nashriveraramirez0520-art/Duet-MIDI/docs/images/README.md

# Design screenshots

- `schematic.png`: schematic screenshot supplied with the project.
- `pcb-layout.png`: routed layout with final control labels.
- `pcb-front-3d.png` and `pcb-back-3d.png`: KiCad 3D views; some component models are missing.
- `routing-drc.png`: zero-violation, zero-unconnected routing check, before final reference-text cleanup; schematic parity was disabled and five checks ignored.

These are design screenshots, not photographs of assembled hardware.
