nashriveraramirez0520-art/Duet-MIDI/docs/images/pcb-back-3d.png

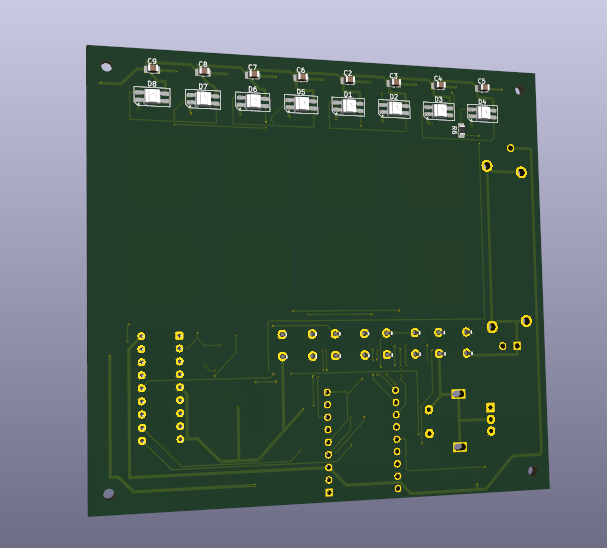
docs/images/pcb-back-3d.png
