nashriveraramirez0520-art/Duet-MIDI/docs/images/routing-drc.png

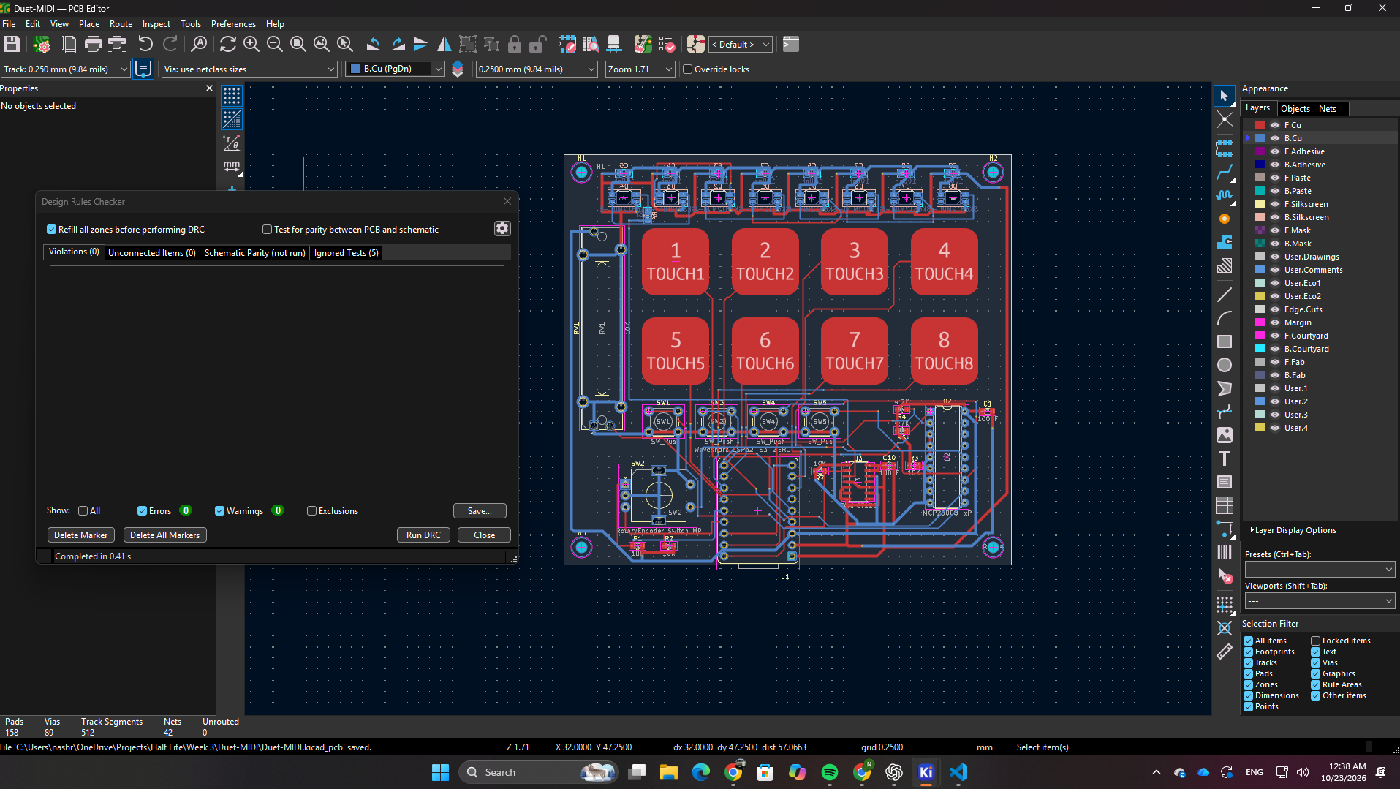
docs/images/routing-drc.png
