nashriveraramirez0520-art/Duet-MIDI/BOM.csv

Item | Qty | Supplier | Cost/item | Total Cost | link
Waveshare ESP32-S3-Zero module (U1) | 1
MCP23008 DIP-18 7.62mm (U2) | 1
74AHCT125 SOIC-14 3.9mm narrow 1.27mm pitch (U3) | 1
SK6812MINI-E RGB reverse-mount LED (D1-D8) | 8
6x6mm THT pushbutton 4.3mm height (SW1 SW3 SW4 SW5) | 4
Switched vertical EC11-type encoder; exact footprint-compatible part TBD (SW2) | 1
10kOhm linear slide pot PTA3043-compatible 30mm travel; full SKU TBD (RV1) | 1
100nF ceramic capacitor 0805 (C1-C10) | 10
10kOhm resistor 0805 (R1 R2 R3 R7) | 4
4.7kOhm resistor 0805 (R4 R5) | 2
330Ohm resistor 0805 (R6) | 1
Custom two-layer PCB; one assembled unit; supplier order quantity TBD | 1
1x9 male header strip 2.54mm pitch | 2 | Already owned: user header kit | 0 | 0
M2 through screw; length and head TBD after stack check | 4
M2 nut | 4
1mm acrylic bottom window 85.6x65.6mm R3.8; cutting included in quote | 1
Printed bottom case | 1
Printed top cover; latest LED-tube revision required | 1
Printed button extension | 4
Printed encoder knob | 1
Printed slider cap | 1
USB data cable; USB-C at board end | 1
