nashriveraramirez0520-art/Duet-MIDI/cad/enclosure-v1/step/top-cover.step

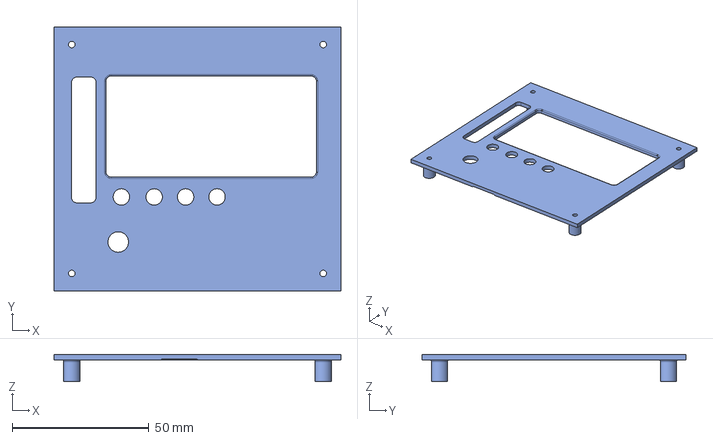
[picture p6: CAD file, 2026-10-25]
cad/enclosure-v1/step/top-cover.step
105.0 x 96.8 x 9.90 mm
