nashriveraramirez0520-art/Duet-MIDI/cad/enclosure-v1/step/button-2.step

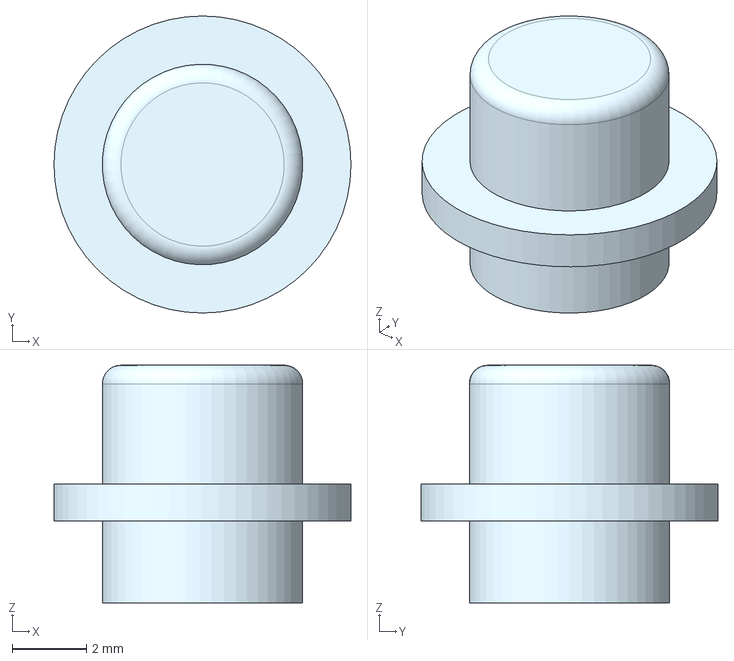
[picture p7: CAD file, 2026-10-25]
cad/enclosure-v1/step/button-2.step
8.00 x 8.00 x 6.40 mm
