nashriveraramirez0520-art/Duet-MIDI/cad/enclosure-v1/step/encoder-knob.step

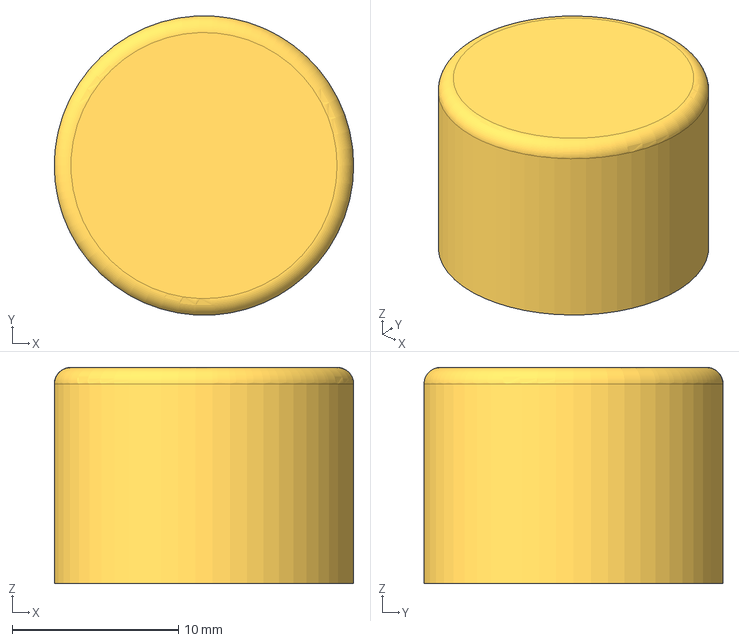
[picture p8: CAD file, 2026-10-25]
cad/enclosure-v1/step/encoder-knob.step
18.0 x 18.0 x 13.0 mm
