nashriveraramirez0520-art/Duet-MIDI/cad/enclosure-v1/step/bottom-case.step

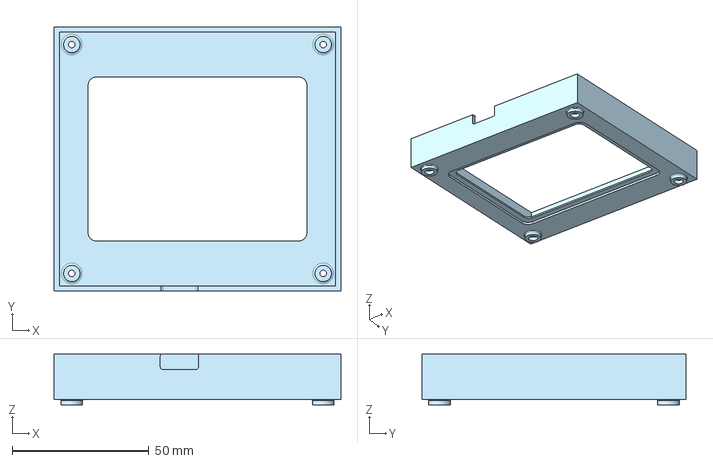
[picture p9: CAD file, 2026-10-25]
cad/enclosure-v1/step/bottom-case.step
105.0 x 96.8 x 18.5 mm
