nashriveraramirez0520-art/Duet-MIDI/cad/enclosure-v1/step/slider-cap.step

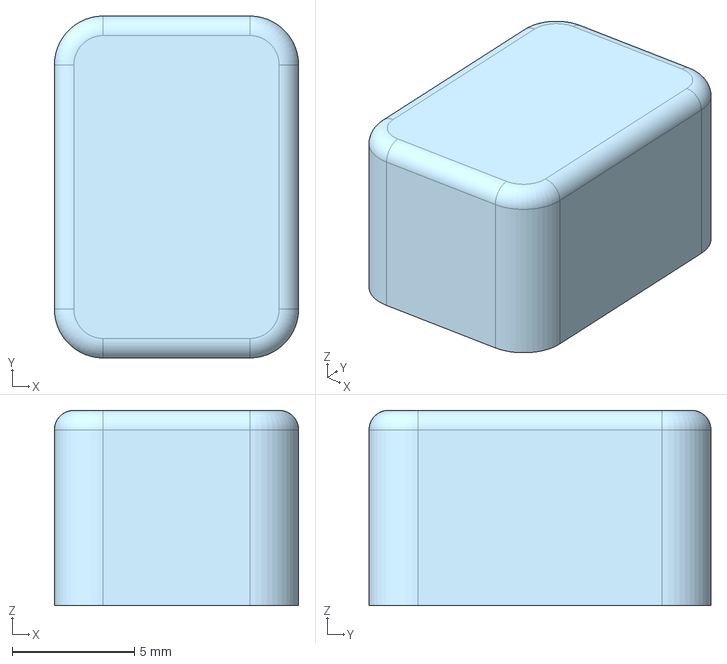
[picture p10: CAD file, 2026-10-25]
cad/enclosure-v1/step/slider-cap.step
10.0 x 14.0 x 8.00 mm
