nashriveraramirez0520-art/Duet-MIDI/(list of files, cad)

Other CAD files:
cad/enclosure-v1/step/button-4.step
cad/enclosure-v1/step/button-3.step
cad/enclosure-v1/step/button-1.step
cad/enclosure-v1/stl/bottom-case.stl
cad/enclosure-v1/stl/button-1.stl
cad/enclosure-v1/stl/button-2.stl
cad/enclosure-v1/stl/button-3.stl
cad/enclosure-v1/stl/button-4.stl
cad/enclosure-v1/stl/encoder-knob.stl
cad/enclosure-v1/stl/slider-cap.stl
cad/enclosure-v1/stl/top-cover.stl
