nashriveraramirez0520-art/Duet-MIDI/JOURNAL.md

# Duet-MIDI development journal

Record actual work sessions, design decisions, issues, and evidence as the project develops. Repository initialization does not establish a number of hours worked.

For each entry, include:

- Date and actual time spent.
- Goal and work completed.
- Decisions and problems encountered.
- Screenshots or links showing progress.
- What remains untested and the next step.

No timed development entry has been recorded yet.
