nashriveraramirez0520-art/Duet-MIDI/pcb/Duet-MIDI.kicad_pcb

## KiCad design pcb/Duet-MIDI.kicad_pcb (2026-10-23)

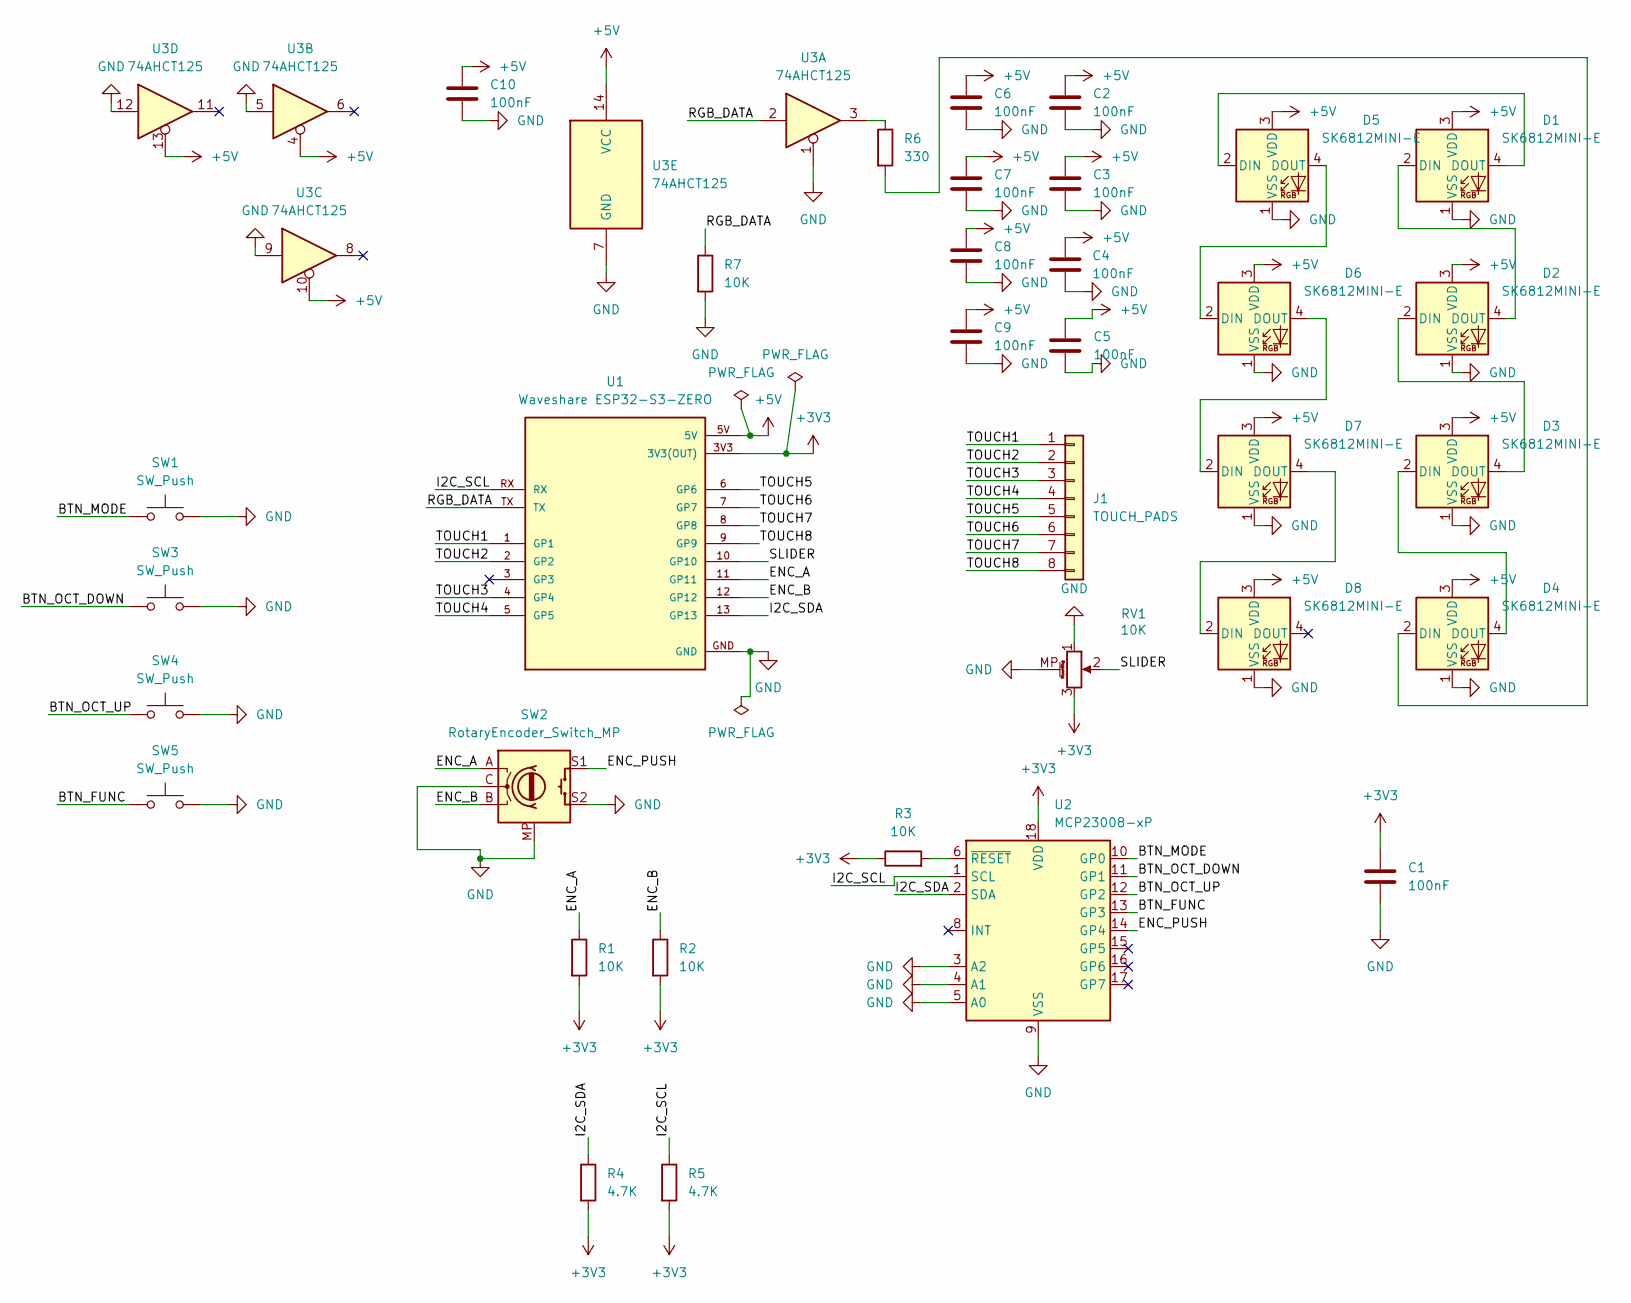
[picture p11: schematic Duet-MIDI.kicad_sch]

Parts:
C1, C2, C3, C4, C5, C6, C7, C8, C9, C10: 100nF; C_0805_2012Metric_Pad1.18x1.45mm_HandSolder
D1, D2, D3, D4, D5, D6, D7, D8: SK6812MINI-E; LED_SK6812MINI-E_3.2x2.8mm_P1.5mm_ReverseMount
J1: TOUCH_PADS; Duet_TouchPads_8
R1, R2, R3, R7: 10K; R_0805_2012Metric_Pad1.20x1.40mm_HandSolder
R4, R5: 4.7K; R_0805_2012Metric_Pad1.20x1.40mm_HandSolder
R6: 330; R_0805_2012Metric_Pad1.20x1.40mm_HandSolder
RV1: 10K; Potentiometer_Bourns_PTA3043_Single_Slide
SW1, SW3, SW4, SW5: SW_Push; SW_PUSH_6mm_H4.3mm
SW2: RotaryEncoder_Switch_MP; RotaryEncoder_Alps_EC11E-Switch_Vertical_H20mm
U1: Waveshare ESP32-S3-ZERO; Waveshare ESP32-S3-Zero; PARTREV NA
U2: MCP23008-xP; DIP-18_W7.62mm
U3: 74AHCT125; SOIC-14_3.9x8.7mm_P1.27mm

Connections:
+3V3: C1.1, R1.2, R2.2, R3.1, R4.2, R5.2, RV1.3, U1.3V3 (3V3(OUT)), U2.18 (VDD)
+5V: C2.1, C3.1, C4.1, C5.1, C6.1, C7.1, C8.1, C9.1, C10.1, D1.3 (VDD), D2.3 (VDD), D3.3 (VDD), D4.3 (VDD), D5.3 (VDD), D6.3 (VDD), D7.3 (VDD), D8.3 (VDD), U1.5V, U3.4, U3.10, U3.13, U3.14 (VCC)
/BTN_FUNC: SW5.1, U2.13 (GP3)
/BTN_MODE: SW1.1, U2.10 (GP0)
/BTN_OCT_DOWN: SW3.1, U2.11 (GP1)
/BTN_OCT_UP: SW4.1, U2.12 (GP2)
/ENC_A: R1.1, SW2.A, U1.11 (GP11)
/ENC_B: R2.1, SW2.B, U1.12 (GP12)
/ENC_PUSH: SW2.S1, U2.14 (GP4)
/I2C_SCL: R5.1, U1.RX, U2.1 (SCL)
/I2C_SDA: R4.1, U1.13 (GP13), U2.2 (SDA)
/RGB_DATA: R7.1, U1.TX, U3.2
/SLIDER: RV1.2, U1.10 (GP10)
/TOUCH1: J1.1, U1.1 (GP1)
/TOUCH2: J1.2, U1.2 (GP2)
/TOUCH3: J1.3, U1.4 (GP4)
/TOUCH4: J1.4, U1.5 (GP5)
/TOUCH5: J1.5, U1.6 (GP6)
/TOUCH6: J1.6, U1.7 (GP7)
/TOUCH7: J1.7, U1.8 (GP8)
/TOUCH8: J1.8, U1.9 (GP9)
GND: C1.2, C2.2, C3.2, C4.2, C5.2, C6.2, C7.2, C8.2, C9.2, C10.2, D1.1 (VSS), D2.1 (VSS), D3.1 (VSS), D4.1 (VSS), D5.1 (VSS), D6.1 (VSS), D7.1 (VSS), D8.1 (VSS), R7.2, RV1.1, RV1.MP (MountPin), SW1.2, SW2.C, SW2.MP, SW2.S2, SW3.2, SW4.2, SW5.2, U1.GND, U2.3 (A2), U2.4 (A1), U2.5 (A0), U2.9 (VSS), U3.1, U3.5, U3.7 (GND), U3.9, U3.12
unnamed: D1.2 (DIN), D2.4 (DOUT)
unnamed: D1.4 (DOUT), D5.2 (DIN)
unnamed: D2.2 (DIN), D3.4 (DOUT)
unnamed: D3.2 (DIN), D4.4 (DOUT)
unnamed: D4.2 (DIN), R6.2
unnamed: D5.4 (DOUT), D6.2 (DIN)
unnamed: D6.4 (DOUT), D7.2 (DIN)
unnamed: D7.4 (DOUT), D8.2 (DIN)
unnamed: R6.1, U3.3
unnamed: R3.2, U2.6 (~RESET)

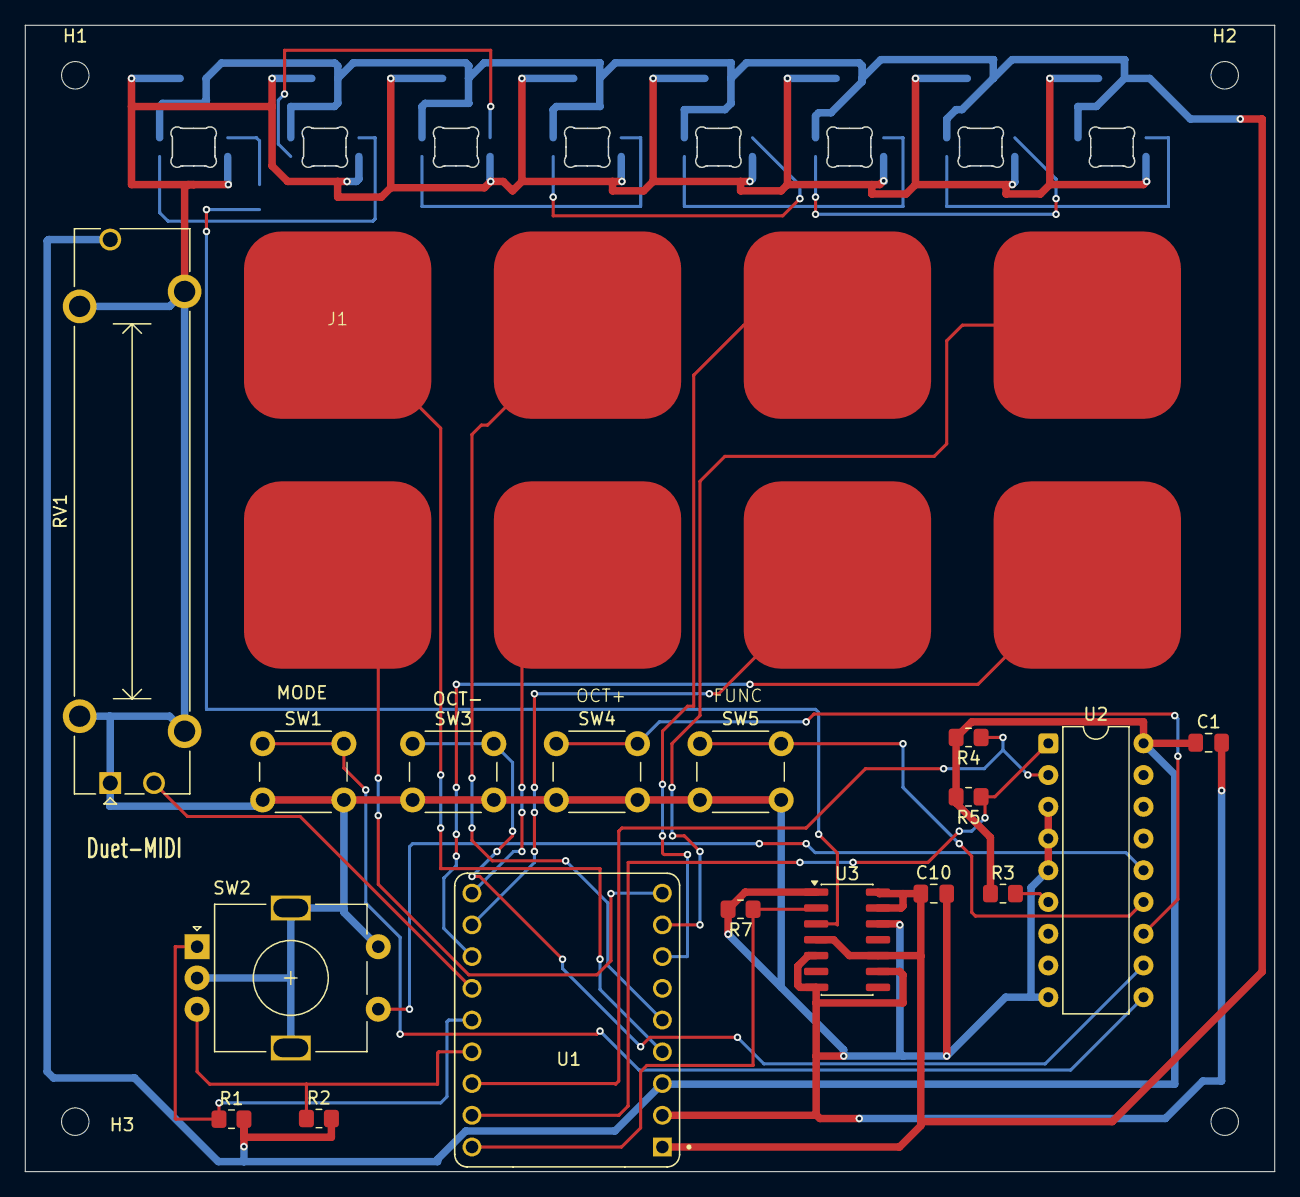
[picture p12: board Duet-MIDI.kicad_pcb from above]

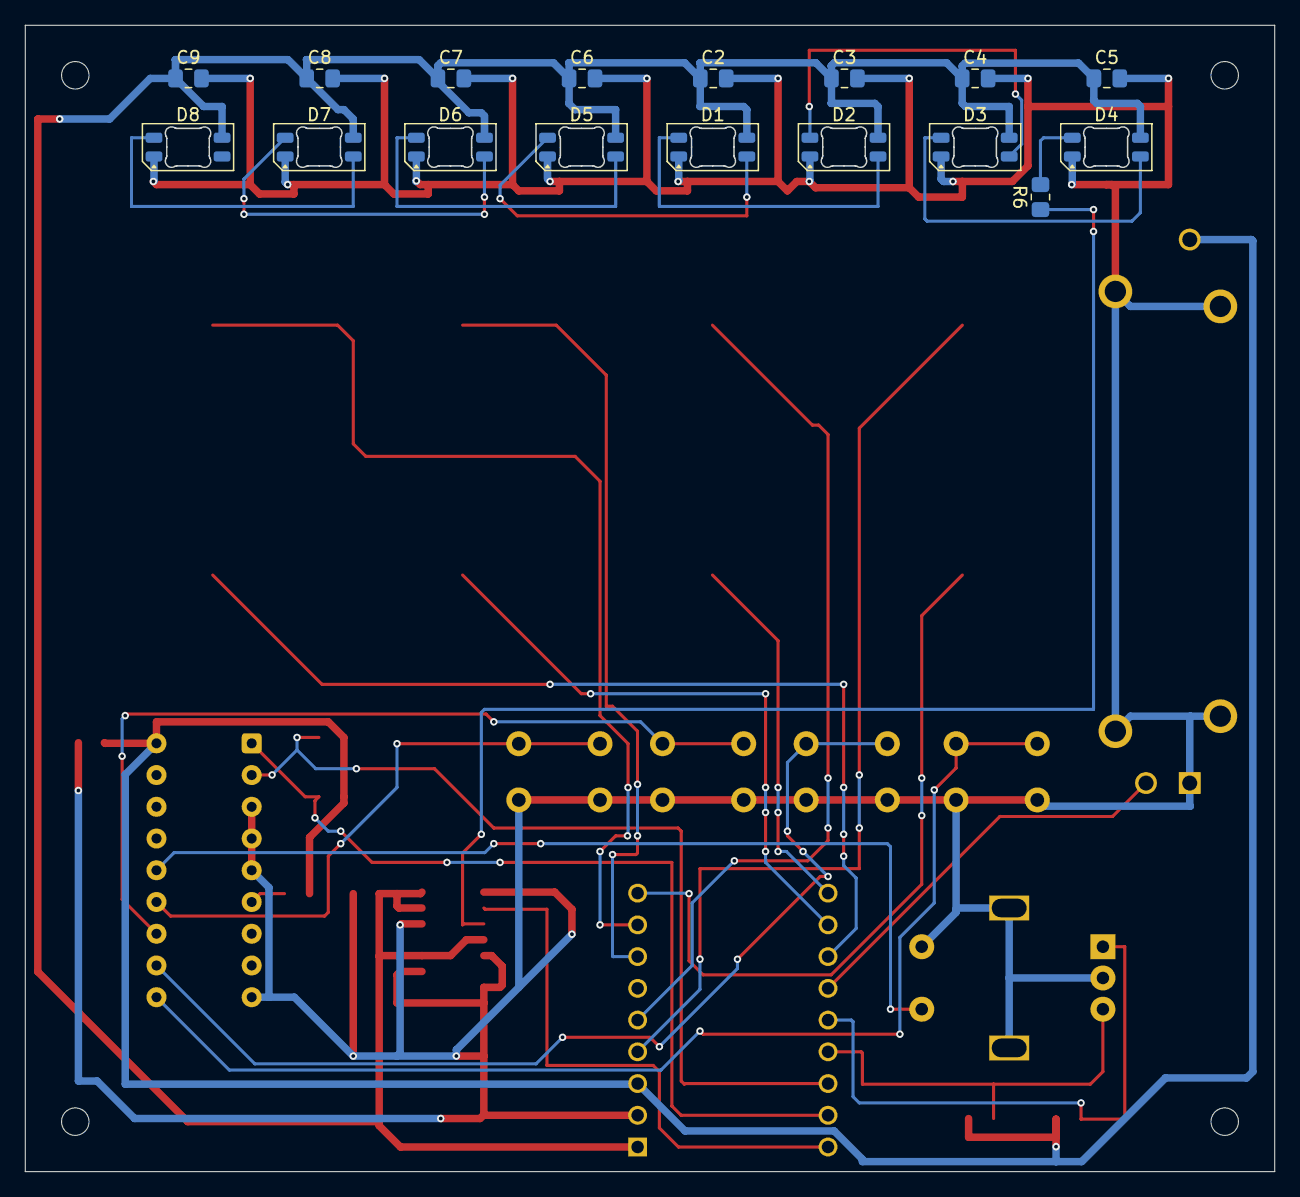
[picture p13: board Duet-MIDI.kicad_pcb from below]

Board: 2 copper layers, 100.0 x 91.8 mm, 39 parts (17 on the bottom side), 32 nets.

Other parts of the board:
H1, H2, H3: MountingHole_2.2mm_M2
REFH4: MountingHole_2.2mm_M2
