nashriveraramirez0520-art/Duet-MIDI/(commit log)

2026-10-23 Add routed KiCad project, Gerbers, and design photos; rewrite README
2026-10-25 Add enclosure V1 CAD, printable meshes, and fit-test notes
2026-10-25 Add CircuitPython firmware V1, logic tests, and component-count BOM draft
2026-10-26 Add CAD source link to README
    Added link to editable CAD source on Onshape.
